ThingsRobMade/CableCam_with_Blynk/Hardware/MotorShelfFinal.stl

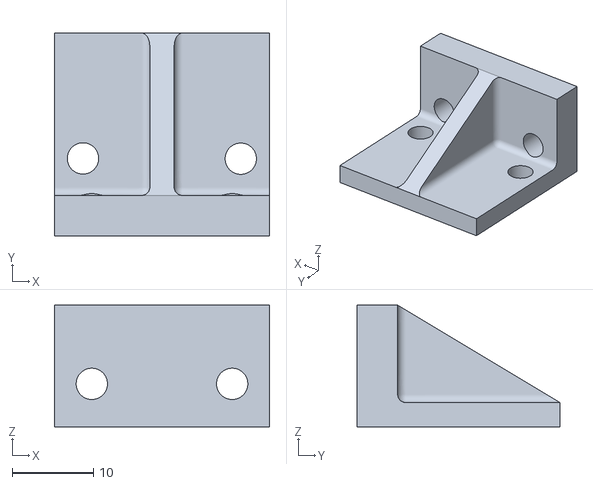
[picture p1: CAD file, 2018-07-17]
Hardware/MotorShelfFinal.stl
26.5 x 25.0 x 15.0
