ThingsRobMade/CableCam_with_Blynk/Hardware/DrivePulleyFinal.stl

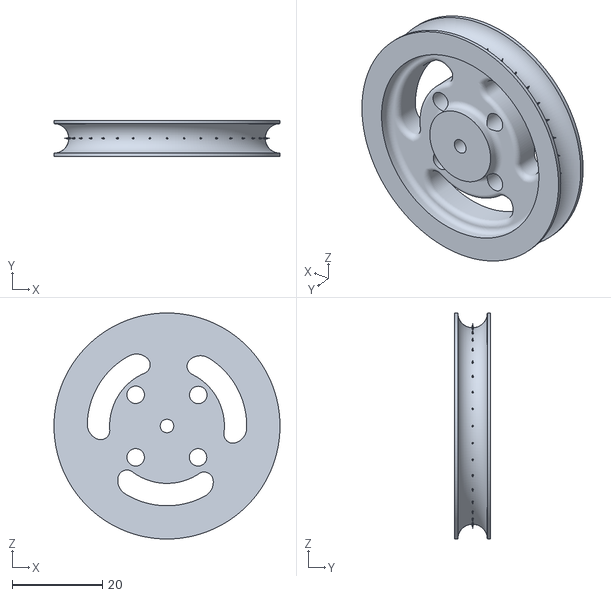
[picture p2: CAD file, 2018-07-16]
Hardware/DrivePulleyFinal.stl
50.0 x 8.00 x 50.0
