ThingsRobMade/CableCam_with_Blynk/Hardware/BodyRightFinal.stl

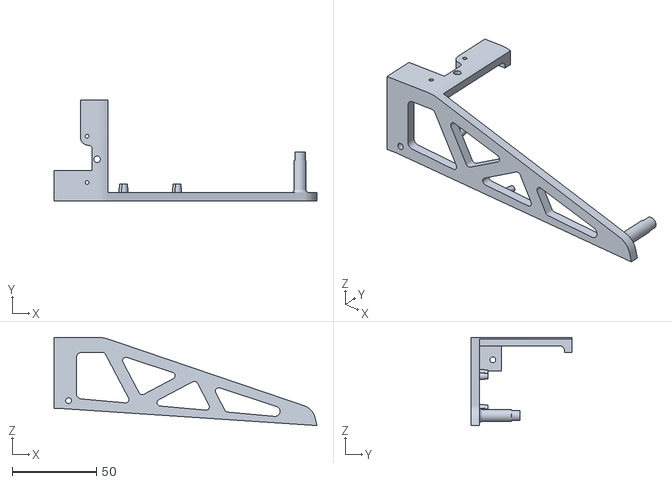
[picture p3: CAD file, 2018-07-16]
Hardware/BodyRightFinal.stl
156.0 x 60.0 x 52.3
