ThingsRobMade/CableCam_with_Blynk/Hardware/BodyLeftFinal.stl

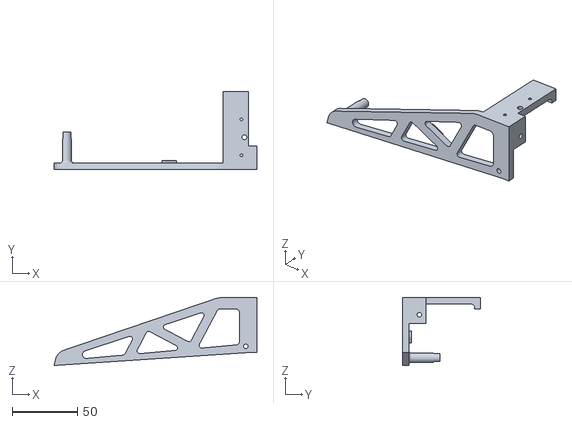
[picture p4: CAD file, 2018-07-16]
Hardware/BodyLeftFinal.stl
156.0 x 60.0 x 52.3
