ThingsRobMade/CableCam_with_Blynk/Hardware/IdlerPulleyFinal.stl

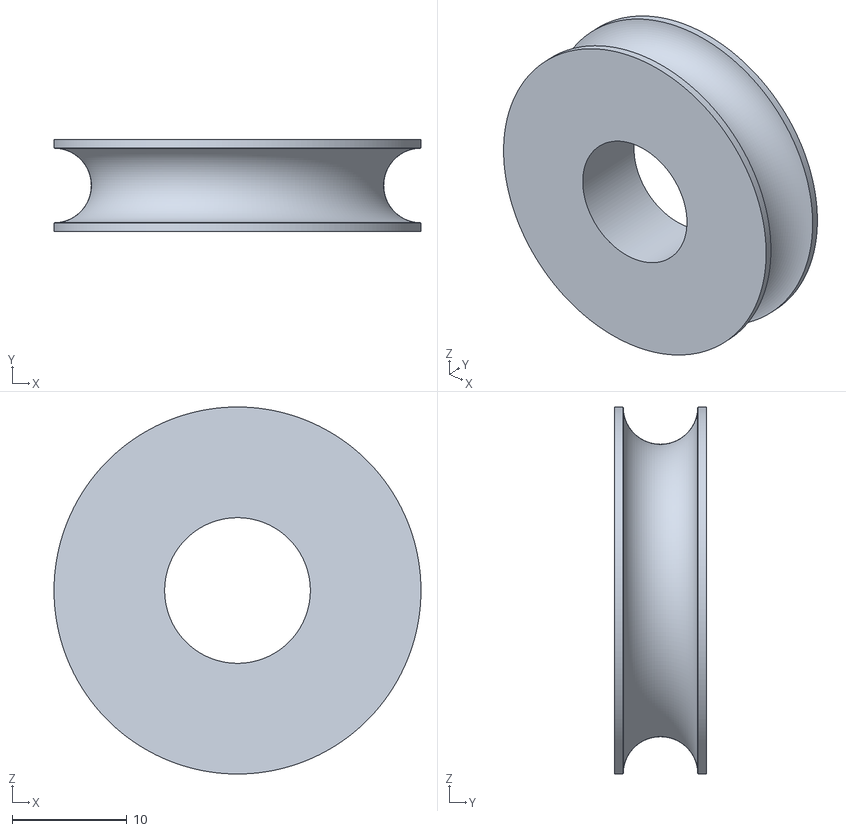
[picture p5: CAD file, 2018-07-16]
Hardware/IdlerPulleyFinal.stl
32.0 x 8.00 x 32.0
