ThingsRobMade/CableCam_with_Blynk/(commit log)

2018-07-16 Initial commit
    Uploading first files and folders
    [BodyLeftFinal.stl, BodyRightFinal.stl, DrivePulleyFinal.stl, IdlerPulleyFinal.stl]
2018-07-17 Initial File Commit
    Uploading blog, code, .stl files.
2018-07-17 Update .stl files, add images
    [MotorShelfFinal.stl]
